Shayshez/Apex4ROBOTS/README.md

# Apex4ROBOTS
1u Peaks for Intellijel format
