Shayshez/Apex4ROBOTS/warning.png

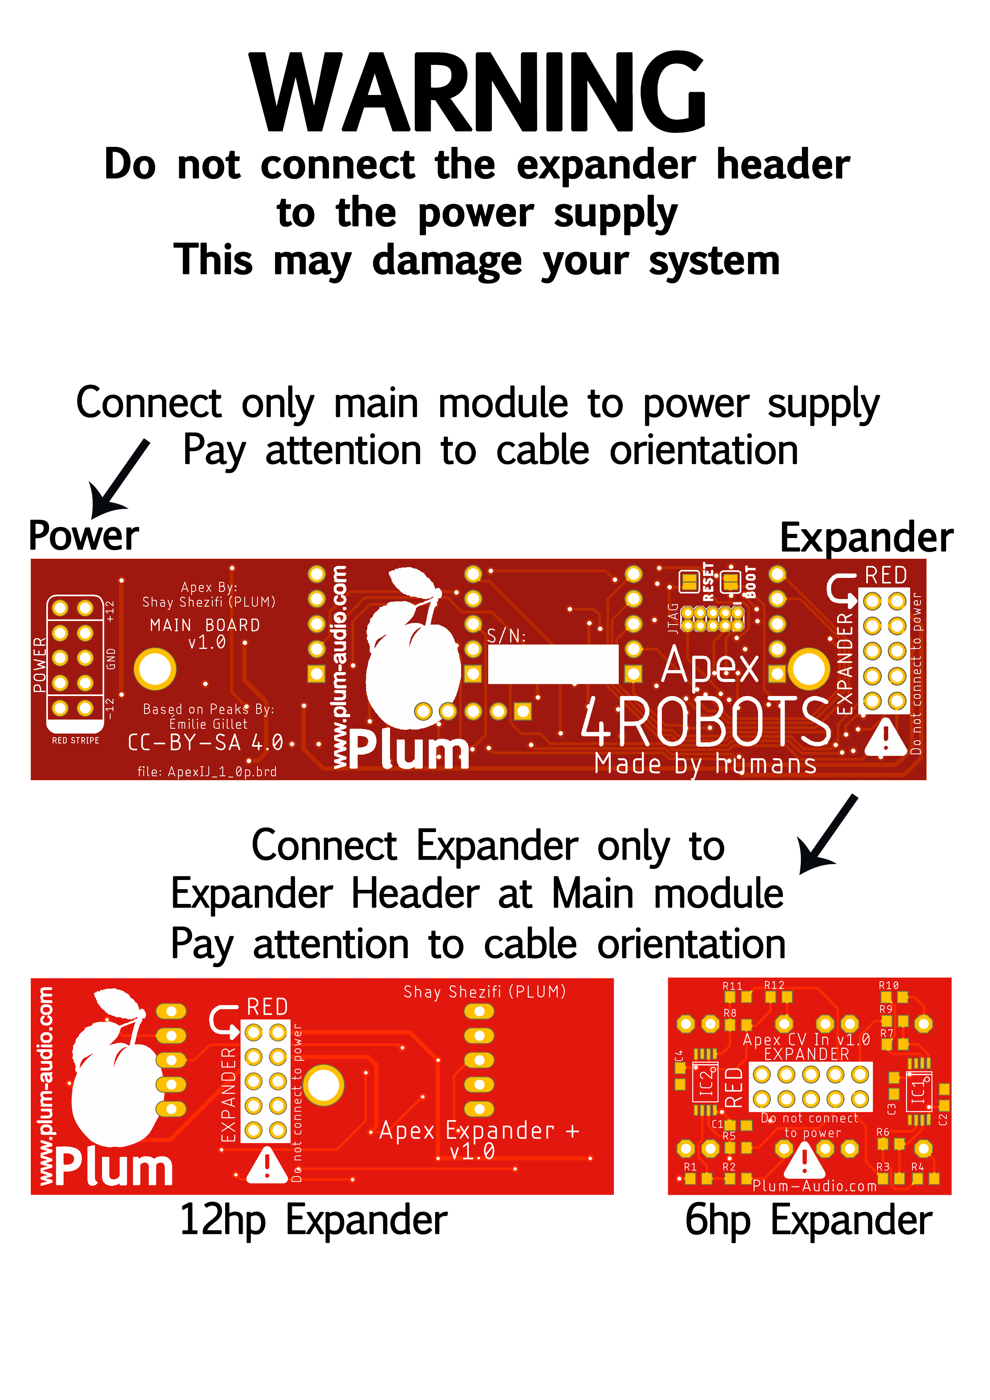
warning.png
