Shayshez/Apex4ROBOTS/Apex4ROBOTS-BOM.xlsx

Sheet: MainBoard
Qty | Value | Device | Package | Parts | Description
1 | 330R | R-US_R0603 | R0603 | R21 | RESISTOR, American symbol
7 | 1.0k | R-US_R0603 | R0603 | R3, R9, R10, R11, R13, R18, R20 | RESISTOR, American symbol
1 | 3.3k | R-US_R0603 | R0603 | R8 | RESISTOR, American symbol
2 | 10k | R-US_R0603 | R0603 | R6, R7 | RESISTOR, American symbol
4 | 33k | R-US_R0603 | R0603 | R1, R2, R4, R5 | RESISTOR, American symbol
6 | 39k | R-US_R0603 | R0603 | R12, R14, R16, R19, R22, R24 | RESISTOR, American symbol
2 | 249k | R-US_R0603 | R0603 | R15, R23 | RESISTOR, American symbol
2 | 309k | R-US_R0603 | R0603 | R17, R25 | RESISTOR, American symbol
4 | 18p | C-USC0603 | C0603 | C4, C5, C21, C25 | CAPACITOR, American symbol
4 | 220p | C-USC0603 | C0603 | C16, C17, C22, C23 | CAPACITOR, American symbol
4 | 560p | C-USC0603 | C0603 | C1, C2, C6, C7 | CAPACITOR, American symbol
11 | 100n | C-USC0603 | C0603 | C3, C8, C9, C10, C11, C13, C14, C19, C20, C24, C27 | CAPACITOR, American symbol
2 | 470n | C-USC0603 | C0603 | C15, C26 | CAPACITOR, American symbol
1 | 3.3u | C-USC0603 | C0603 | C18 | CAPACITOR, American symbol
3 | 22u | CPOL-USC | PANASONIC_C | C12, C28, C29 | POLARIZED CAPACITOR, American symbol
1 | EMI Bead | WE-CBF_0603 | 603 | L1 | SMD EMI Suppression Ferrite Beads
2 | 1N5819HW | DIODE-SOD123 | SOD123 | D1, D2 | DIODE
1 | LM1117-3.3 | REG1117 | SOT223 | IC3 | 800mA and 1A Low Dropout (LDO) Positive Regulator
1 | DAC8552 | DAC8552 | MSOP-8 | IC2
1 | LM4040B10 | LM4041B12DBZ | DBZ_R-PDSO-G3 | IC6 | PRECISION MICROPOWER SHUNT VOLTAGE REFERENCE
1 | LM4040B25 | LM4041B12DBZ | DBZ_R-PDSO-G3 | IC4 | PRECISION MICROPOWER SHUNT VOLTAGE REFERENCE
1 | MCP6004TSSOP14 | MCP6004TSSOP14 | TSSOP14 | IC1
2 | TL072TL072_TSSOP8 | TL072TL072_TSSOP8 | TL072_TSSOP8 | IC5, IC7
1 | STM32F103CBT6 | STM32F103CB | LQFP48 | UC1
1 | 8.0Mhz Crystal | CRYSTAL7A | XTAL500X320X120 | Q1 | CRYSTAL
5 |  | 61300511121 | 61300511121 | J1, J2, J3, J4, J5 | WR-PHD 2.54mm Pin Header, 5 Pin =>Code : Con_BTB_PHD_2.54_1_THT_61300511121
1 |  | 61301021121 | 61301021121 | EXPANDER | WR-PHD 2.54mm Dual Pin Header, 10 Pins =>Code : Con_BTB_PHD_2.54_2_61301021121
1 | M05X2MINIJTAG | M05X2MINIJTAG | 2X5-1.27 | JTAG | Header 5x2
1 | POWER_SIMPLE10 | POWER_SIMPLE10 | POWER_10 | POWER

Sheet: UI Board
Qty | Value | Device | Package | Parts | Description | SPICEPREFIX
2 | 100R | R-US_R0603 | R0603 | R5, R6 | RESISTOR, American symbol
6 | 100k | R-US_R0603 | R0603 | R7, R8, R9, R10, R11, R12 | RESISTOR, American symbol
2 | 10k | R-US_R0603 | R0603 | R19, R25 | RESISTOR, American symbol
4 | 10kB | POTS_POT_USSLOTED_TALL_TRIMMER | POTS_TALL_TRIMMER_POT_VERTICAL_SLOTED | R1, R2, R3, R4
2 | MMBT3904 | MMBT3904LT1-NPN-SOT23-BEC | SOT23-BEC | Q2, Q3 | NPN Transistror
2 | HIGHLY_PB6149L | HIGHLY_PB6149L | HIGHLY_PB64149L | SW_T2, SW_T1
2 | Switch, 6mm | Switch, 6mm | Switch, 6mm | SW1, SW2 | Momentary Switch |  | 612-TL1105SP-250
2 | Cap for switch |  |  | SW1, SW2
5 | LED3MM | LED3MM | LED3MM | LED1, LED2, LED3, LED4, LED5 | LED
4 | OG-PJ301_PJ301_THONKICONN6 | OG-PJ301_PJ301_THONKICONN6 | OG-PJ301_WQP_PJ_301M6 | OUT_A, OUT_B, TRIG_A, TRIG_B
5 | Pin Header Female 2.54 1X5 | Pin Header Female 2.54 1X5 | Pin Header Female 2.54 1X5 | J5, J6, J7, J8, J9 | WR-PHD 2.54mm Pin Header, 5 Pin =>Code : Con_BTB_PHD_2.54_1_THT_61300511121

Sheet: 12HP Ex MainBoard
Qty | Value | Device | Package | Parts | Description | POPULARITY
1 | Pin Headers 2.54 2X5 | 61301021121 | 61301021121 | EXPANDER | WR-PHD 2.54mm Dual Pin Header, 10 Pins =>Code : Con_BTB_PHD_2.54_2_61301021121
2 | Pin Headers 2.54 1X5 | PINHD-1X5 | 1X05 | JP1, JP2 | PIN HEADER | 69
12 | 100.0K | R-US_R0603 | R0603 | R5, R6, R7, R10, R11, R13, R16, R17, R18, R21, R22, R23 | RESISTOR, American symbol
4 | 75K | R-US_R0603 | R0603 | R8, R14, R19, R24 | RESISTOR, American symbol
8 | 100n | C-USC0603 | C0603 | C1, C2, C3, C4, C5, C6, C7, C24 | CAPACITOR, American symbol
4 | TL072TL072_TSSOP8 | TL072TL072_TSSOP8 | TL072_TSSOP8 | IC3, IC4, IC5, IC6

Sheet: 12HP Ex UI Board
Qty | Value | Device | Package | Parts | Description | POPULARITY
2 | Pin Header Female 1X5 | PINHD-1X5 | 1X05 | JP1, JP2 | PIN HEADER | 69
4 | 100.0K | R-US_R0603 | R0603 | R5, R6, R7, R8 | RESISTOR, American symbol
4 | 10kB | POTS_POT_USSLOTED_TALL_TRIMMER | POTS_TALL_TRIMMER_POT_VERTICAL_SLOTED | R1, R2, R3, R4
4 | PJ301_THONKICONN | PJ301_THONKICONN | WQP_PJ_301M6 | J1, J2, J3, J4

Sheet: 6HP CV INS
Qty | Value | Device | Package | Parts | Description
8 | 100K | R-US_R0603 | R0603 | R1, R2, R4, R6, R7, R8, R10, R12 | RESISTOR, American symbol
4 | 75K | R-US_R0603 | R0603 | R3, R5, R9, R11 | RESISTOR, American symbol
4 | 100n | C-USC0603 | C0603 | C1, C2, C3, C4 | CAPACITOR, American symbol
4 | PJ301_THONKICONN | PJ301_THONKICONN | WQP_PJ_301M6 | J1, J2, J3, J4
2 | TL072TL072_TSSOP8 | TL072TL072_TSSOP8 | TL072_TSSOP8 | IC1, IC2
1 | Pin Headers 2.54 2X5 | 61301021121 | 61301021121 | EXPANDER | WR-PHD 2.54mm Dual Pin Header, 10 Pins =>Code : Con_BTB_PHD_2.54_2_61301021121
