Shayshez/Apex4ROBOTS/Expanders/3u:2hp/Apex_CV_Expander_3U_UI_v1.0.brd

## EAGLE design Expanders/3u:2hp/Apex_CV_Expander_3U_UI_v1.0.brd (2020-03-17)

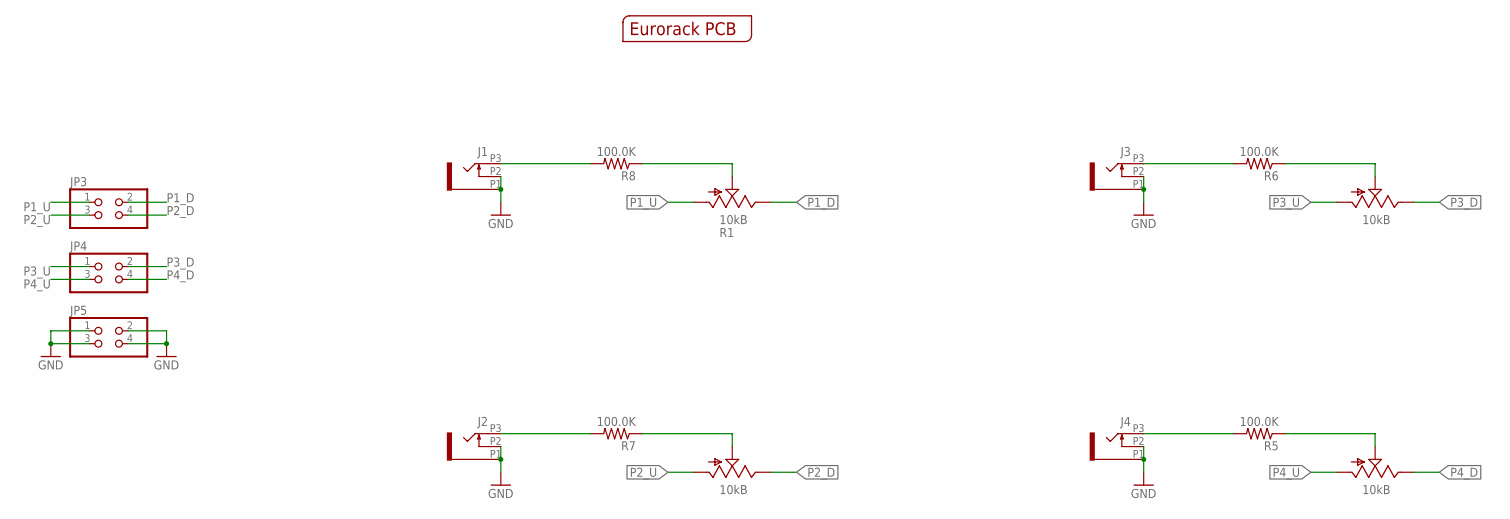
[picture p2: schematic Apex_CV_Expander_3U_UI_v1.0.sch]

Parts:
J1, J2, J3, J4: OG-PJ301_PJ301_THONKICONN7; OG-PJ301_WQP_PJ_301M7
JP3, JP4, JP5: PINHD-2X2; 2X02
PCB1: EURORACK_PCB2HP; EURORACK2HPPCB
R1, R2, R3, R4: 10kB; POTS_TALL_TRIMMER_POT_VERTICAL_SLOTED
R5, R6, R7, R8: 100.0K; R0603

Connections:
GND: J1.P1 (1), J1.P2 (2), J2.P1 (1), J2.P2 (2), J3.P1 (1), J3.P2 (2), J4.P1 (1), J4.P2 (2), JP5.1, JP5.2, JP5.3, JP5.4
unnamed: J1.P3 (3), R8.2
unnamed: R1.P$2 (S), R8.1
unnamed: J2.P3 (3), R7.2
unnamed: R2.P$2 (S), R7.1
unnamed: J3.P3 (3), R6.2
unnamed: R3.P$2 (S), R6.1
unnamed: J4.P3 (3), R5.2
unnamed: R4.P$2 (S), R5.1
P1_D: JP3.2, R1.P$1 (E)
P1_U: JP3.1, R1.P$3 (A)
P2_D: JP3.4, R2.P$1 (E)
P2_U: JP3.3, R2.P$3 (A)
P3_D: JP4.2, R3.P$1 (E)
P3_U: JP4.1, R3.P$3 (A)
P4_D: JP4.4, R4.P$1 (E)
P4_U: JP4.3, R4.P$3 (A)

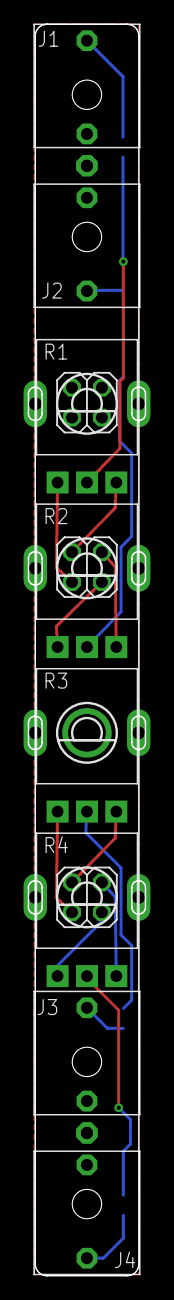
[picture p3: board Apex_CV_Expander_3U_UI_v1.0.brd from above]

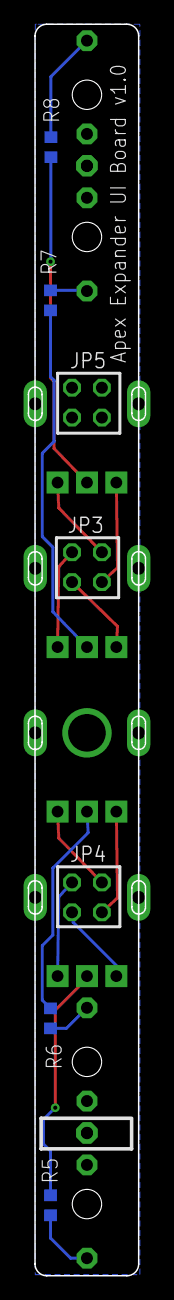
[picture p4: board Apex_CV_Expander_3U_UI_v1.0.brd from below]

Board: 2 copper layers, 10.0 x 106.5 mm, 16 parts (4 on the bottom side), 17 nets.
