Shayshez/Apex4ROBOTS/Expanders/3u:2hp/Apex_CV_Expander_3U_v1.0.brd

## EAGLE design Expanders/3u:2hp/Apex_CV_Expander_3U_v1.0.brd (2020-03-17)

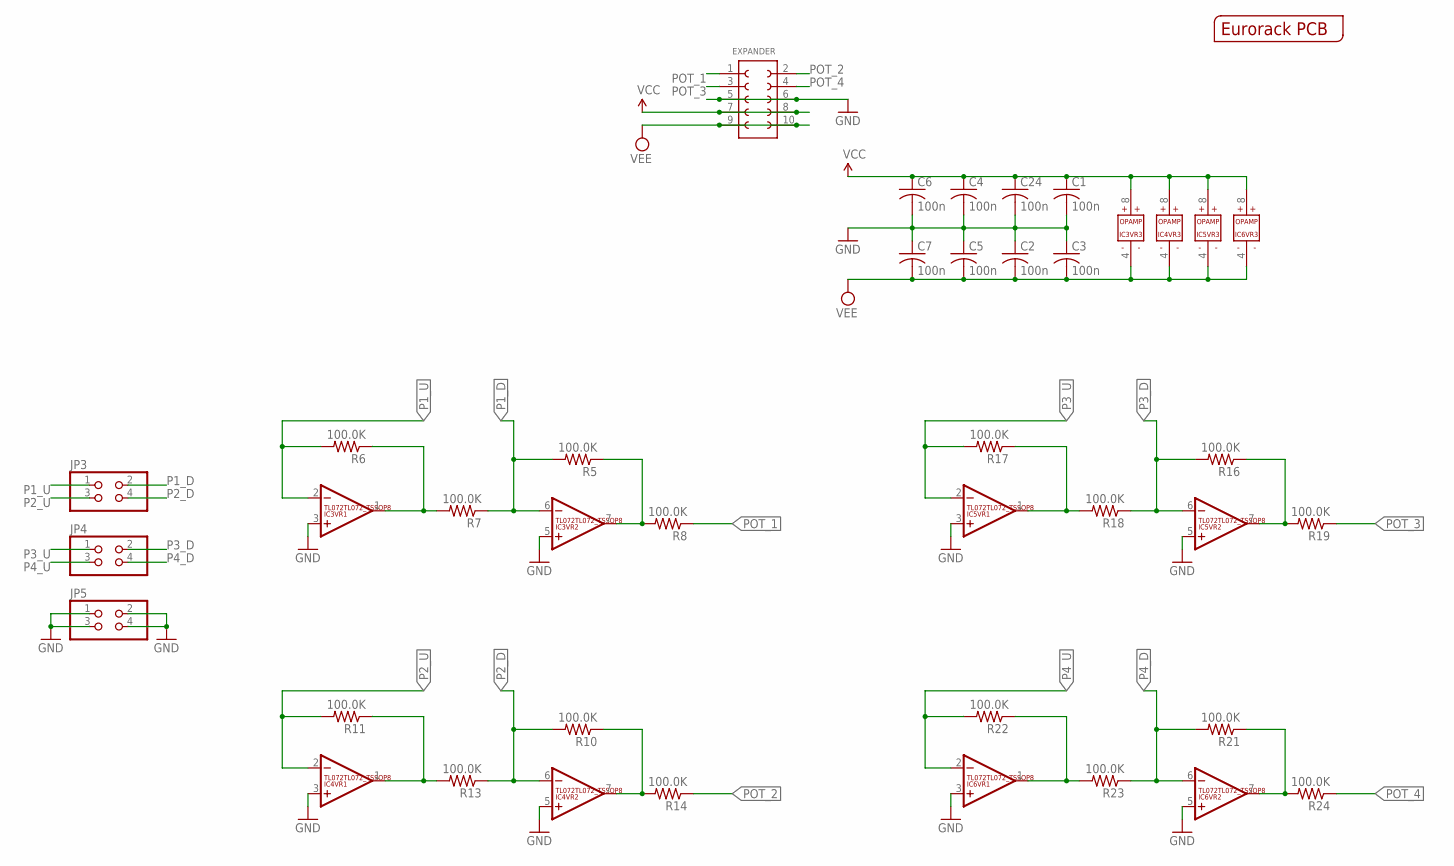
[picture p5: schematic Apex_CV_Expander_3U_v1.0.sch]

Parts:
C1, C2, C3, C4, C5, C6, C7, C24: 100n; C0603
EXPANDER: 61301021121
IC3, IC4, IC5, IC6: TL072TL072_TSSOP8; TL072_TSSOP8
JP3, JP4, JP5: PINHD-2X2; 2X02
PCB1: EURORACK_PCB2HP; EURORACK2HPPCB
R5, R6, R7, R8, R10, R11, R13, R14, R16, R17, R18, R19, R21, R22, R23, R24: 100.0K; R0603

Connections:
GND: C1.2, C2.1, C3.1, C4.2, C5.1, C6.2, C7.1, C24.2, EXPANDER.5 (3), EXPANDER.6 (8), IC3.3 (+IN), IC3.5 (+IN), IC4.3 (+IN), IC4.5 (+IN), IC5.3 (+IN), IC5.5 (+IN), IC6.3 (+IN), IC6.5 (+IN), JP5.1, JP5.2, JP5.3, JP5.4
unnamed: IC3.7 (OUT), R5.1, R8.2
unnamed: IC3.1 (OUT), R6.1, R7.2
unnamed: IC4.7 (OUT), R10.1, R14.2
unnamed: IC4.1 (OUT), R11.1, R13.2
unnamed: IC5.7 (OUT), R16.1, R19.2
unnamed: IC5.1 (OUT), R17.1, R18.2
unnamed: IC6.7 (OUT), R21.1, R24.2
unnamed: IC6.1 (OUT), R22.1, R23.2
P1_D: IC3.6 (-IN), JP3.2, R5.2, R7.1
P1_U: IC3.2 (-IN), JP3.1, R6.2
P2_D: IC4.6 (-IN), JP3.4, R10.2, R13.1
P2_U: IC4.2 (-IN), JP3.3, R11.2
P3_D: IC5.6 (-IN), JP4.2, R16.2, R18.1
P3_U: IC5.2 (-IN), JP4.1, R17.2
P4_D: IC6.6 (-IN), JP4.4, R21.2, R23.1
P4_U: IC6.2 (-IN), JP4.3, R22.2
POT_1: EXPANDER.1, R8.1
POT_2: EXPANDER.2 (10), R14.1
POT_3: EXPANDER.3 (2), R19.1
POT_4: EXPANDER.4 (9), R24.1
VCC: C1.1, C4.1, C6.1, C24.1, EXPANDER.7 (4), EXPANDER.8 (7), IC3.8 (V+), IC4.8 (V+), IC5.8 (V+), IC6.8 (V+)
VEE: C2.2, C3.2, C5.2, C7.2, EXPANDER.9 (5), EXPANDER.10 (6), IC3.4 (V-), IC4.4 (V-), IC5.4 (V-), IC6.4 (V-)

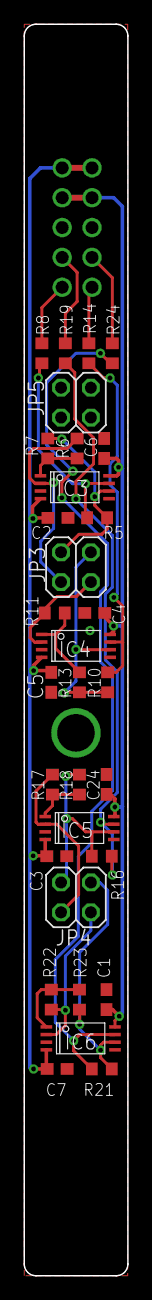
[picture p6: board Apex_CV_Expander_3U_v1.0.brd from above]

Board: 2 copper layers, 8.8 x 106.5 mm, 33 parts (1 on the bottom side), 23 nets.
