Shayshez/Apex4ROBOTS/Apex4ROBOTS_1_0.brd

## EAGLE design Apex4ROBOTS_1_0.brd (2019-12-17)

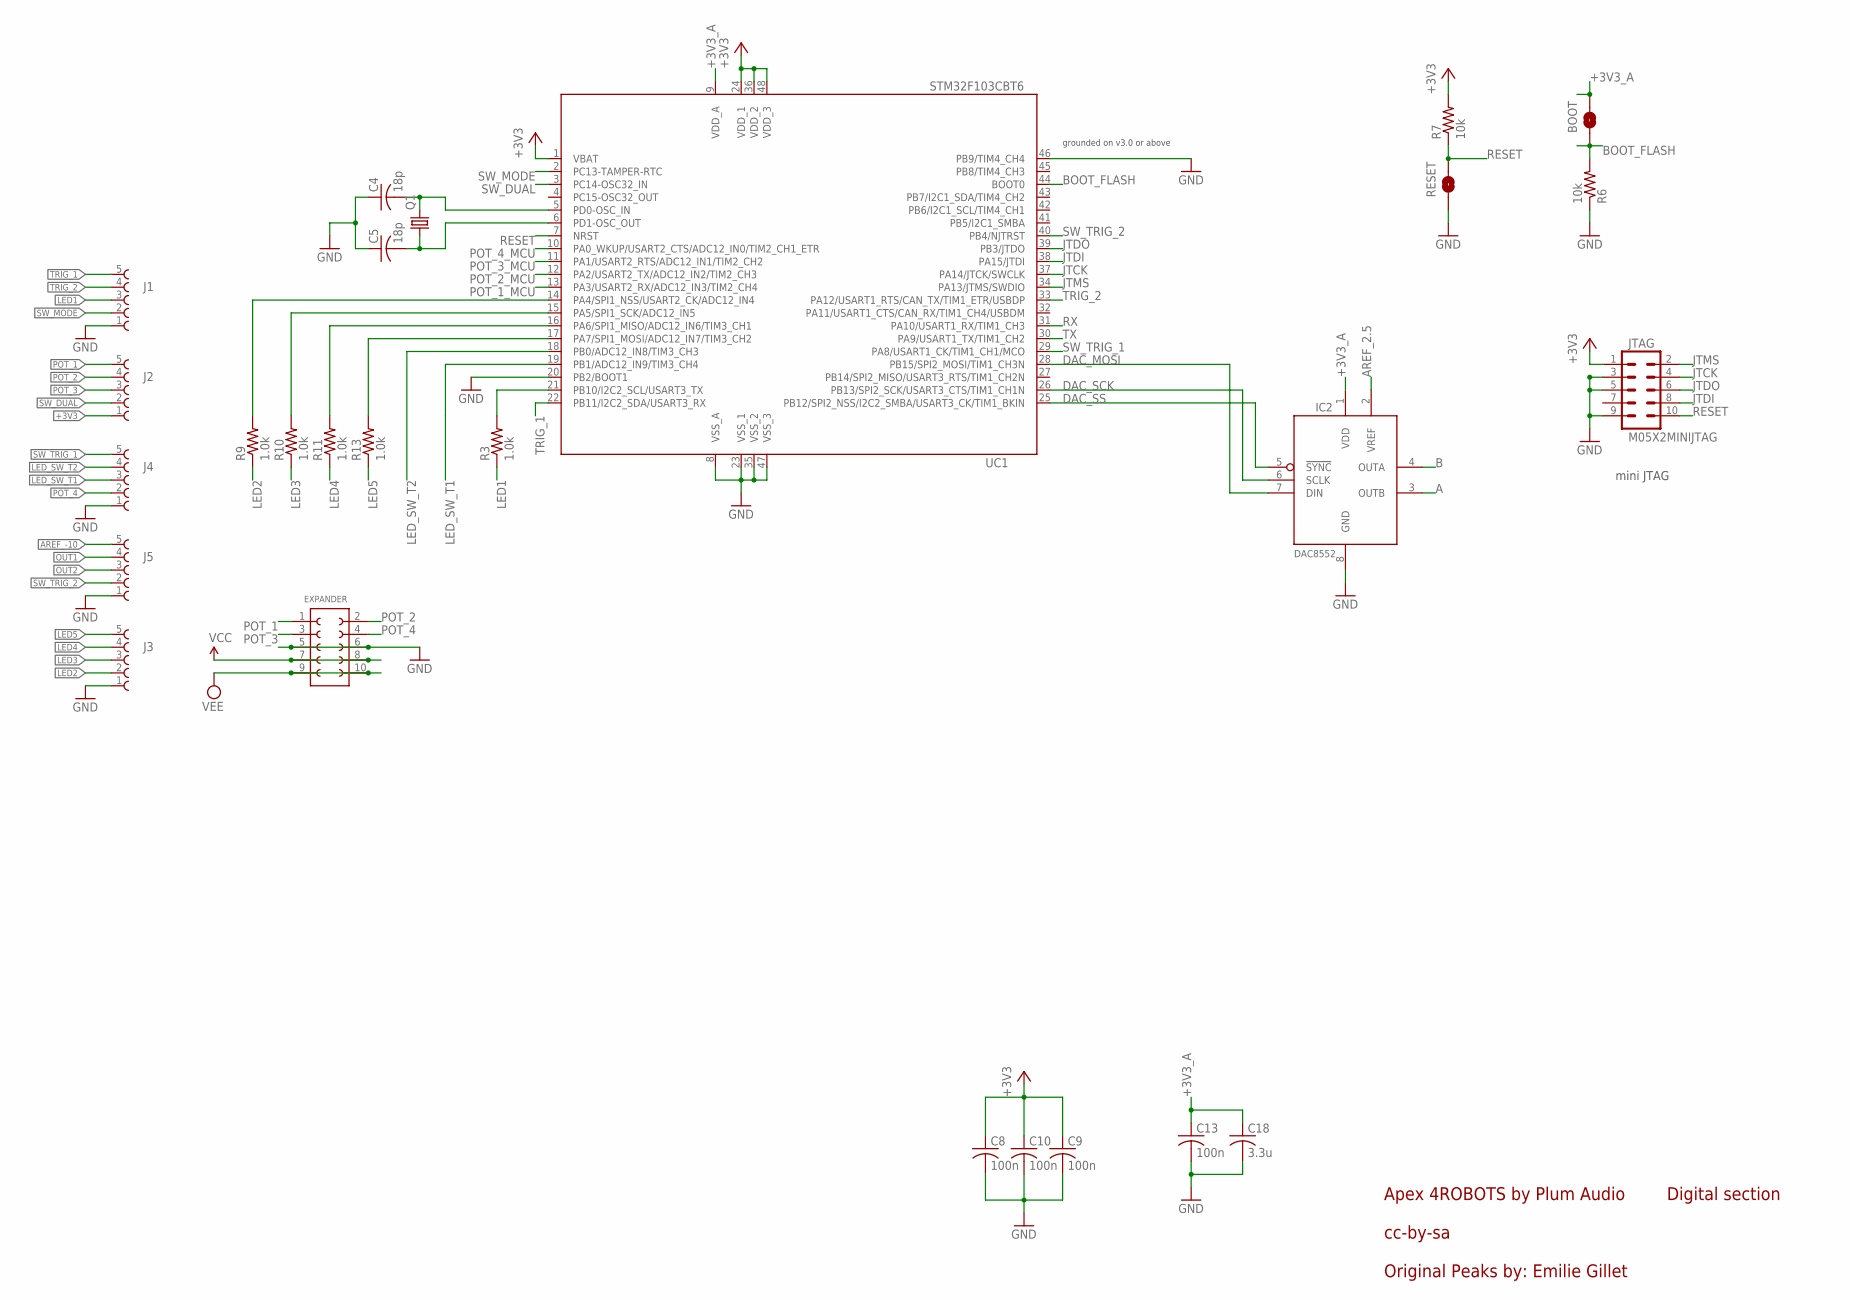
[picture p7: schematic Apex4ROBOTS_1_0.sch, sheet 1]

Parts:
BOOT: BOOT; SMT-JUMPER_2_NO_SILK
C4, C5: 18p; C0603
C8, C9, C10, C13: 100n; C0603
C18: 3.3u; C0603
EXPANDER: 61301021121
IC2: DAC8552; MSOP-8
J1, J2, J3, J4, J5: 61300511121
JTAG: M05X2MINIJTAG; 2X5-1.27
Q1: CRYSTAL7A; XTAL500X320X120
R3, R9, R10, R11, R13: 1.0k; R0603
R6, R7: 10k; R0603
RESET: RESET; SMT-JUMPER_2_NO_SILK
UC1: STM32F103CBT6; LQFP48

Connections:
+3V3: C8.1, C9.1, C10.1, J2.1 (5), JTAG.1, R7.2, UC1.1 (VBAT), UC1.24 (VDD_1), UC1.36 (VDD_2), UC1.48 (VDD_3); also elsewhere on the board
+3V3_A: BOOT.2, C13.1, C18.1, IC2.1 (VDD), UC1.9 (VDD_A); also elsewhere on the board
A: IC2.3 (OUTB); also elsewhere on the board
AREF_2.5: IC2.2 (VREF); also elsewhere on the board
AREF_-10: J5.5 (1); also elsewhere on the board
B: IC2.4 (OUTA); also elsewhere on the board
BOOT_FLASH: BOOT.1, R6.2, UC1.44 (BOOT0)
DAC_MOSI: IC2.7 (DIN), UC1.28 (PB15/SPI2_MOSI/TIM1_CH3N)
DAC_SCK: IC2.6 (SCLK), UC1.26 (PB13/SPI2_SCK/USART3_CTS/TIM1_CH1N)
DAC_SS: IC2.5 (!SYNC), UC1.25 (PB12/SPI2_NSS/I2C2_SMBA/USART3_CK/TIM1_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)
GND: C4.1, C5.1, C8.2, C9.2, C10.2, C13.2, C18.2, EXPANDER.5 (3), EXPANDER.6 (8), IC2.8 (GND), J1.1 (5), J3.1 (5), J4.1 (5), J5.1 (5), JTAG.3, JTAG.5, JTAG.9, R6.1, RESET.1, UC1.8 (VSS_A), UC1.20 (PB2/BOOT1), UC1.23 (VSS_1), UC1.35 (VSS_2), UC1.46 (PB9/TIM4_CH4), UC1.47 (VSS_3); also elsewhere on the board
JTCK: JTAG.4, UC1.37 (PA14/JTCK/SWCLK)
JTDI: JTAG.8, UC1.38 (PA15/JTDI)
JTDO: JTAG.6, UC1.39 (PB3/JTDO)
JTMS: JTAG.2, UC1.34 (PA13/JTMS/SWDIO)
LED1: J1.3, R3.1
LED2: J3.2 (4), R9.1
LED3: J3.3, R10.1
LED4: J3.4 (2), R11.1
LED5: J3.5 (1), R13.1
LED_SW_T1: J4.3, UC1.19 (PB1/ADC12_IN9/TIM3_CH4)
LED_SW_T2: J4.4 (2), UC1.18 (PB0/ADC12_IN8/TIM3_CH3)
unnamed: C4.2, Q1.2, UC1.5 (PD0-OSC_IN)
unnamed: C5.2, Q1.1, UC1.6 (PD1-OSC_OUT)
unnamed: R9.2, UC1.14 (PA4/SPI1_NSS/USART2_CK/ADC12_IN4)
unnamed: R10.2, UC1.15 (PA5/SPI1_SCK/ADC12_IN5)
unnamed: R11.2, UC1.16 (PA6/SPI1_MISO/ADC12_IN6/TIM3_CH1)
unnamed: R13.2, UC1.17 (PA7/SPI1_MOSI/ADC12_IN7/TIM3_CH2)
unnamed: R3.2, UC1.21 (PB10/I2C2_SCL/USART3_TX)
OUT1: J5.4 (2); also elsewhere on the board
OUT2: J5.3; also elsewhere on the board
POT_1: EXPANDER.1, J2.5 (1); also elsewhere on the board
POT_1_MCU: UC1.13 (PA3/USART2_RX/ADC12_IN3/TIM2_CH4); also elsewhere on the board
POT_2: EXPANDER.2 (10), J2.4 (2); also elsewhere on the board
POT_2_MCU: UC1.12 (PA2/USART2_TX/ADC12_IN2/TIM2_CH3); also elsewhere on the board
POT_3: EXPANDER.3 (2), J2.3; also elsewhere on the board
POT_3_MCU: UC1.11 (PA1/USART2_RTS/ADC12_IN1/TIM2_CH2); also elsewhere on the board
POT_4: EXPANDER.4 (9), J4.2 (4); also elsewhere on the board
POT_4_MCU: UC1.10 (PA0_WKUP/USART2_CTS/ADC12_IN0/TIM2_CH1_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); also elsewhere on the board
RESET: JTAG.10, R7.1, RESET.2, UC1.7 (NRST)
RX: UC1.31 (PA10/USART1_RX/TIM1_CH3)
SW_DUAL: J2.2 (4), UC1.3 (PC14-OSC32_IN)
SW_MODE: J1.2 (4), UC1.2 (PC13-TAMPER-RTC)
SW_TRIG_1: J4.5 (1), UC1.29 (PA8/USART1_CK/TIM1_CH1/MCO)
SW_TRIG_2: J5.2 (4), UC1.40 (PB4/NJTRST)
TRIG_1: J1.5 (1), UC1.22 (PB11/I2C2_SDA/USART3_RX)
TRIG_2: J1.4 (2), UC1.33 (PA12/USART1_RTS/CAN_TX/TIM1_ETR/USBDP)
TX: UC1.30 (PA9/USART1_TX/TIM1_CH2)
VCC: EXPANDER.7 (4), EXPANDER.8 (7); also elsewhere on the board
VEE: EXPANDER.9 (5), EXPANDER.10 (6); also elsewhere on the board

Notes on the sheet:
cc-by-sa
Original Peaks by: Emilie Gillet
Digital section
mini JTAG
grounded on v3.0 or above
Apex 4ROBOTS by Plum Audio

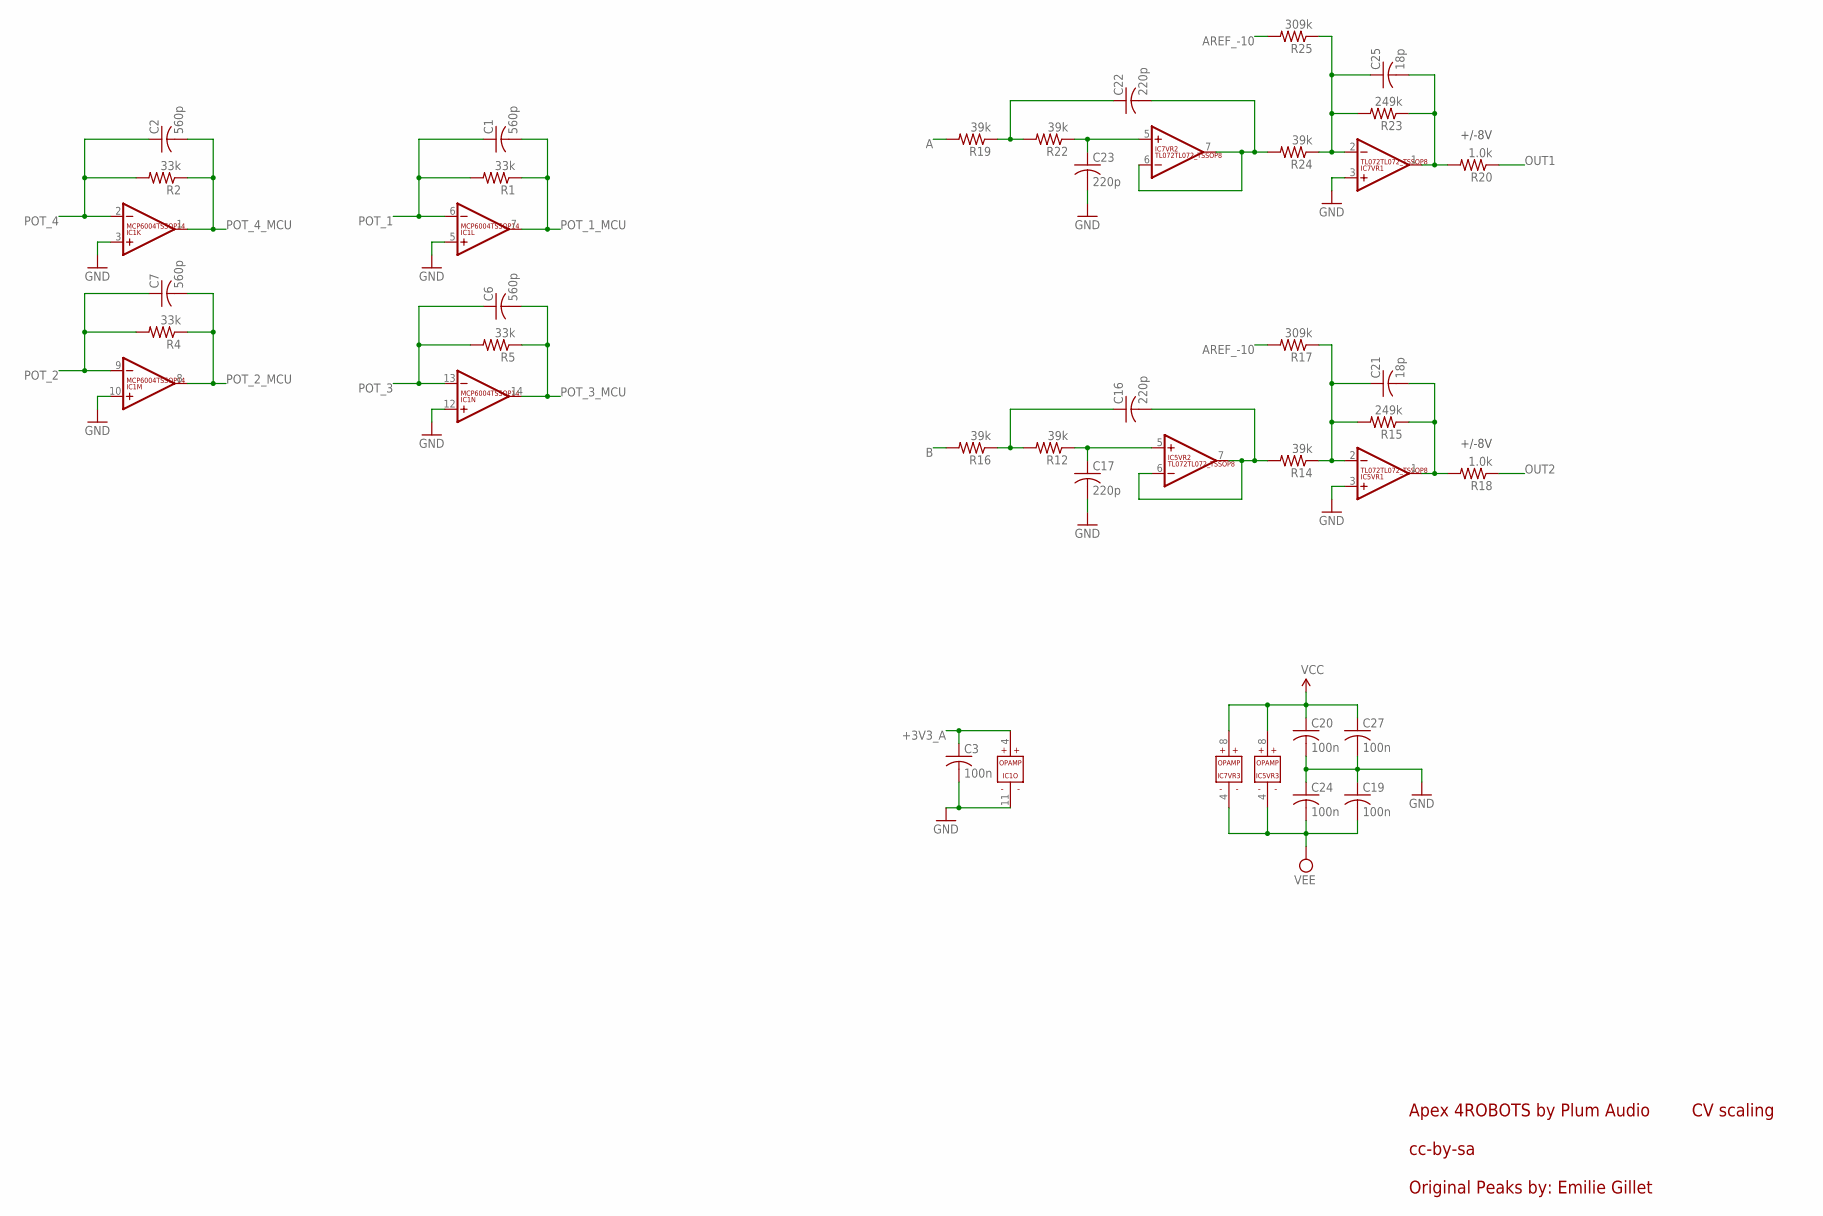
[picture p8: schematic Apex4ROBOTS_1_0.sch, sheet 2]

Parts:
C1, C2, C6, C7: 560p; C0603
C3, C19, C20, C24, C27: 100n; C0603
C16, C17, C22, C23: 220p; C0603
C21, C25: 18p; C0603
IC1: MCP6004TSSOP14; TSSOP14
IC5, IC7: TL072TL072_TSSOP8; TL072_TSSOP8
R1, R2, R4, R5: 33k; R0603
R12, R14, R16, R19, R22, R24: 39k; R0603
R15, R23: 249k; R0603
R17, R25: 309k; R0603
R18, R20: 1.0k; R0603

Connections:
+3V3_A: C3.1, IC1.4 (V+); also elsewhere on the board
A: R19.2; also elsewhere on the board
AREF_-10: R17.2, R25.2; also elsewhere on the board
B: R16.2; also elsewhere on the board
BI_OUT: C21.2, IC5.1 (OUT), R15.1, R18.2
BI_OUT1: C25.2, IC7.1 (OUT), R20.2, R23.1
F_CV: C21.1, IC5.2 (-IN), R14.1, R15.2, R17.1
F_CV1: C25.1, IC7.2 (-IN), R23.2, R24.1, R25.1
GND: C3.2, C17.2, C19.1, C20.2, C23.2, C24.1, C27.2, IC1.3 (+IN), IC1.5 (+IN), IC1.10 (+IN), IC1.11 (V-), IC1.12 (+IN), IC5.3 (+IN), IC7.3 (+IN); also elsewhere on the board
unnamed: C22.2, IC7.6 (-IN), IC7.7 (OUT), R24.2
unnamed: C23.1, IC7.5 (+IN), R22.1
unnamed: C22.1, R19.1, R22.2
unnamed: C16.2, IC5.6 (-IN), IC5.7 (OUT), R14.2
unnamed: C17.1, IC5.5 (+IN), R12.1
unnamed: C16.1, R12.2, R16.1
OUT1: R20.1; also elsewhere on the board
OUT2: R18.1; also elsewhere on the board
POT_1: C1.1, IC1.6 (-IN), R1.2; also elsewhere on the board
POT_1_MCU: C1.2, IC1.7 (OUT), R1.1; also elsewhere on the board
POT_2: C7.1, IC1.9 (-IN), R4.2; also elsewhere on the board
POT_2_MCU: C7.2, IC1.8 (OUT), R4.1; also elsewhere on the board
POT_3: C6.1, IC1.13 (-IN), R5.2; also elsewhere on the board
POT_3_MCU: C6.2, IC1.14 (OUT), R5.1; also elsewhere on the board
POT_4: C2.1, IC1.2 (-IN), R2.2; also elsewhere on the board
POT_4_MCU: C2.2, IC1.1 (OUT), R2.1; also elsewhere on the board
VCC: C20.1, C27.1, IC5.8 (V+), IC7.8 (V+); also elsewhere on the board
VEE: C19.2, C24.2, IC5.4 (V-), IC7.4 (V-); also elsewhere on the board

Notes on the sheet:
+/-8V
CV scaling
cc-by-sa
Original Peaks by: Emilie Gillet
Apex 4ROBOTS by Plum Audio

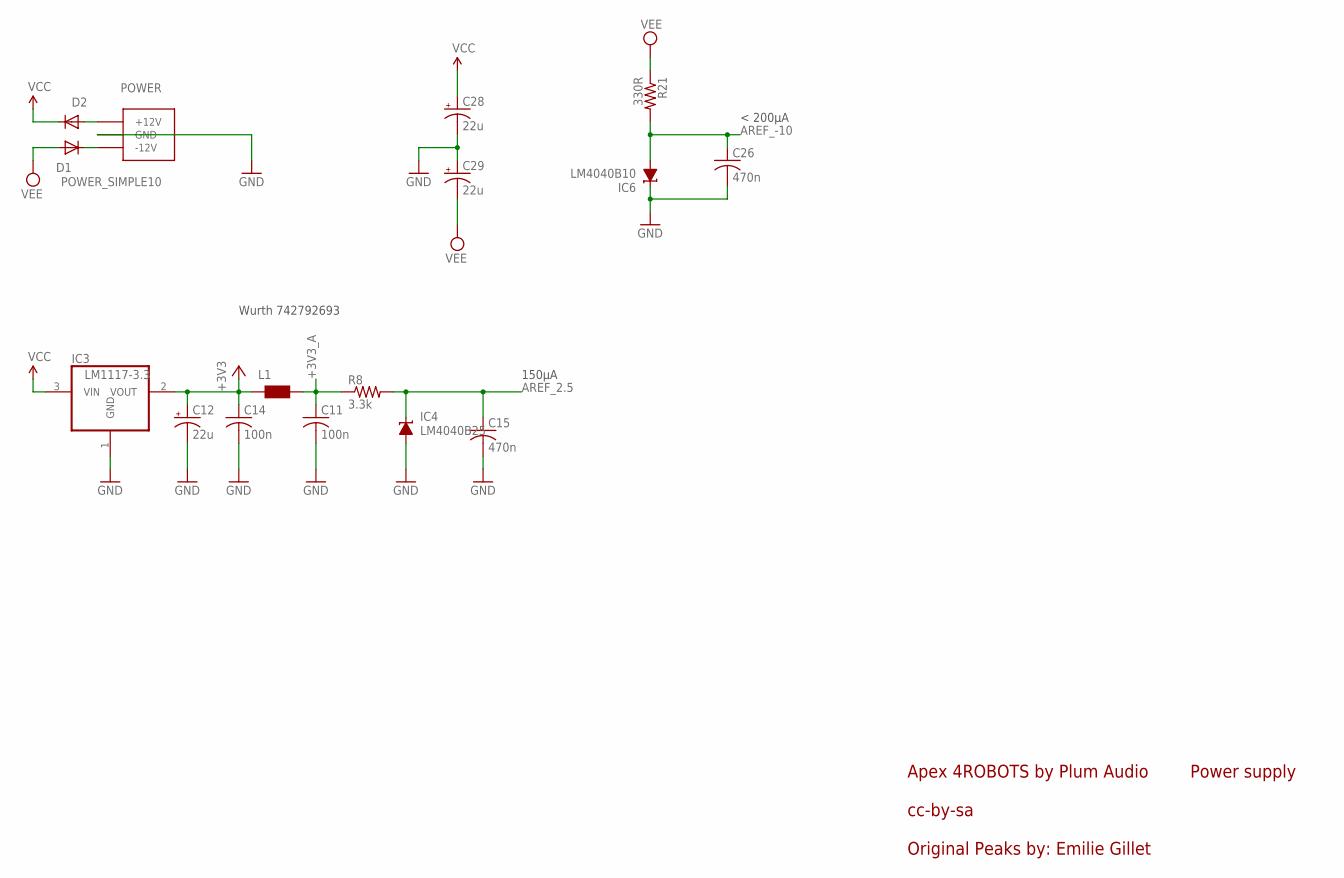
[picture p9: schematic Apex4ROBOTS_1_0.sch, sheet 3]

Parts:
C11, C14: 100n; C0603
C12, C28, C29: 22u; PANASONIC_C
C15, C26: 470n; C0603
D1, D2: 1N5819HW; SOD123
IC3: LM1117-3.3; SOT223
IC4: LM4040B25; DBZ_R-PDSO-G3
IC6: LM4040B10; DBZ_R-PDSO-G3
L1: WE-CBF_0603; 0603
POWER: POWER_SIMPLE10; POWER_10
R8: 3.3k; R0603
R21: 330R; R0603

Connections:
+3V3: C12.+, C14.1, IC3.2 (VOUT), L1.1; also elsewhere on the board
+3V3_A: C11.1, L1.2, R8.1; also elsewhere on the board
AREF_2.5: C15.1, IC4.1 (C), R8.2; also elsewhere on the board
AREF_-10: C26.1, IC6.2 (A), R21.2; also elsewhere on the board
GND: C11.2, C12.-, C14.2, C15.2, C26.2, C28.-, C29.+, IC3.1 (GND), IC4.2 (A), IC6.1 (C), POWER.3 (GND), POWER.4 (GND), POWER.5 (GND), POWER.6 (GND), POWER.7 (GND), POWER.8 (GND); also elsewhere on the board
unnamed: D2.A, POWER.9 (+12V), POWER.10 (+12V)
unnamed: D1.C, POWER.1 (-12V), POWER.2 (-12V)
VCC: C28.+, D2.C, IC3.3 (VIN); also elsewhere on the board
VEE: C29.-, D1.A, R21.1; also elsewhere on the board

Notes on the sheet:
Power supply
Wurth 742792693
< 200µA
150µA
cc-by-sa
Original Peaks by: Emilie Gillet
Apex 4ROBOTS by Plum Audio

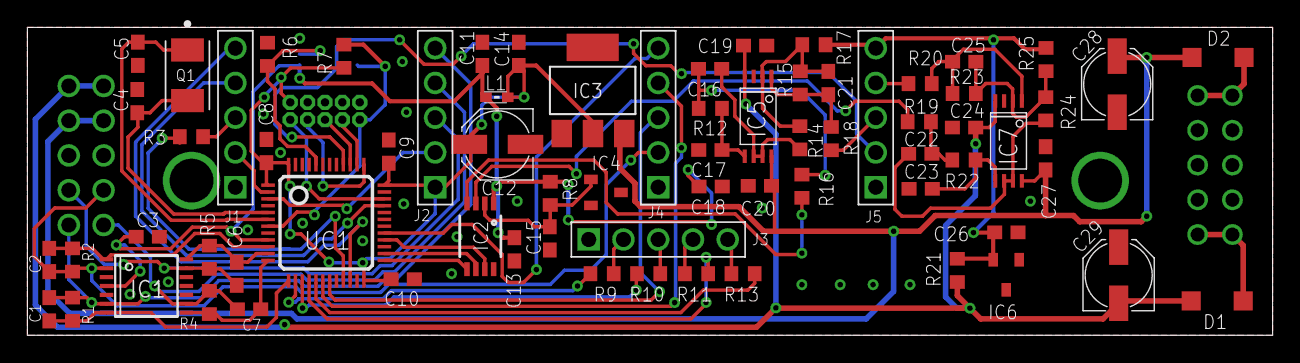
[picture p10: board Apex4ROBOTS_1_0.brd from above]

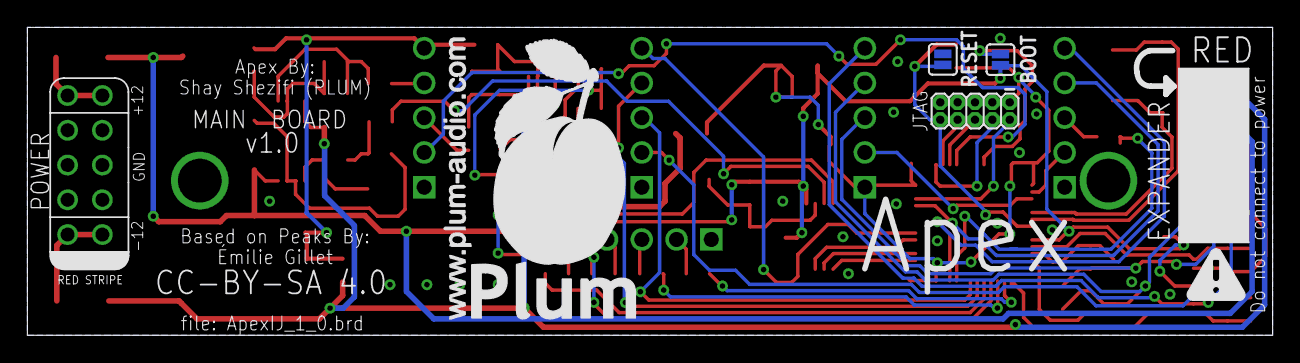
[picture p11: board Apex4ROBOTS_1_0.brd from below]

Board: 2 copper layers, 91.0 x 22.5 mm, 76 parts (5 on the bottom side), 60 nets.
