Shayshez/Apex4ROBOTS/Apex4ROBOTS_UI_1_0.brd

## EAGLE design Apex4ROBOTS_UI_1_0.brd (2019-12-17)

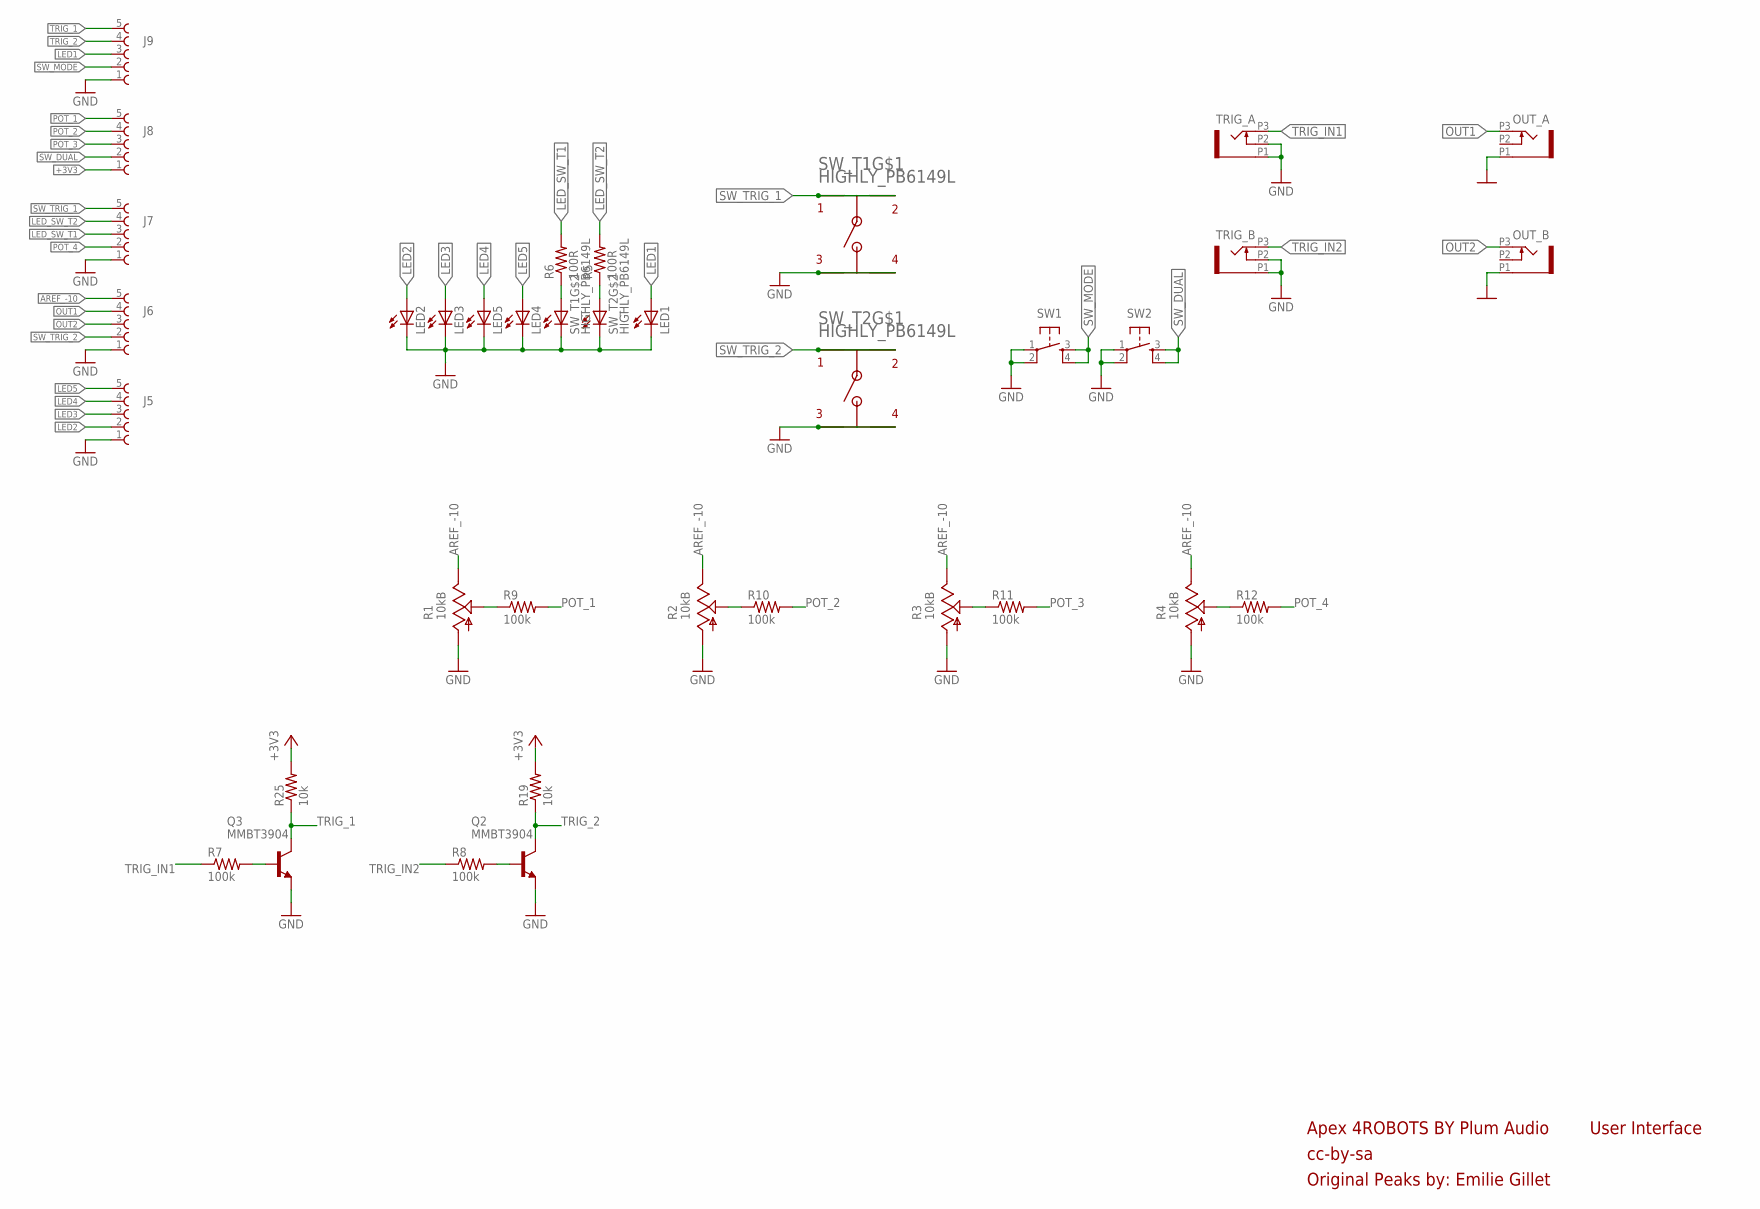
[picture p12: schematic Apex4ROBOTS_UI_1_0.sch]

Parts:
J5, J6, J7, J8, J9: 61300511121
LED1, LED2, LED3, LED4, LED5: LED3MM
OUT_A: OG-PJ301_PJ301_THONKICONN6; OG-PJ301_WQP_PJ_301M6
OUT_B: OG-PJ301_PJ301_THONKICONN6; OG-PJ301_WQP_PJ_301M6
Q2, Q3: MMBT3904; SOT23-BEC
R1, R2, R3, R4: 10kB; POTS_TALL_TRIMMER_POT_VERTICAL_SLOTED
R5, R6: 100R; R0603
R7, R8, R9, R10, R11, R12: 100k; R0603
R19, R25: 10k; R0603
SW1, SW2: TAC_SWITCHPTH; TACTILE-PTH
SW_T1, SW_T2: HIGHLY_PB6149L; HIGHLY_PB64149L
TRIG_A: OG-PJ301_PJ301_THONKICONN6; OG-PJ301_WQP_PJ_301M6
TRIG_B: OG-PJ301_PJ301_THONKICONN6; OG-PJ301_WQP_PJ_301M6

Connections:
+3V3: J8.1 (5), R19.2, R25.2
AREF_-10: J6.5 (1), R1.P$1 (E), R2.P$1 (E), R3.P$1 (E), R4.P$1 (E)
GND: J5.1 (5), J6.1 (5), J7.1 (5), J9.1 (5), LED1.K (C), LED2.K (C), LED3.K (C), LED4.K (C), LED5.K (C), OUT_A.P1 (1), OUT_B.P1 (1), Q2.E, Q3.E, R1.P$3 (A), R2.P$3 (A), R3.P$3 (A), R4.P$3 (A), SW1.1, SW1.2, SW2.1, SW2.2, SW_T1.L2, SW_T1.P$3, SW_T1.P$4, SW_T2.L2, SW_T2.P$3, SW_T2.P$4, TRIG_A.P1 (1), TRIG_A.P2 (2), TRIG_B.P1 (1), TRIG_B.P2 (2)
LED1: J9.3, LED1.A
LED2: J5.2 (4), LED2.A
LED3: J5.3, LED3.A
LED4: J5.4 (2), LED5.A
LED5: J5.5 (1), LED4.A
LED_SW_T1: J7.3, R6.2
LED_SW_T2: J7.4 (2), R5.2
unnamed: R5.1, SW_T2.L1
unnamed: R6.1, SW_T1.L1
unnamed: R1.P$2 (S), R9.1
unnamed: R2.P$2 (S), R10.1
unnamed: R3.P$2 (S), R11.1
unnamed: R4.P$2 (S), R12.1
unnamed: Q2.B, R8.2
unnamed: Q3.B, R7.2
OUT1: J6.4 (2), OUT_A.P3 (3)
OUT2: J6.3, OUT_B.P3 (3)
POT_1: J8.5 (1), R9.2
POT_2: J8.4 (2), R10.2
POT_3: J8.3, R11.2
POT_4: J7.2 (4), R12.2
SW_DUAL: J8.2 (4), SW2.3, SW2.4
SW_MODE: J9.2 (4), SW1.3, SW1.4
SW_TRIG_1: J7.5 (1), SW_T1.P$1, SW_T1.P$2
SW_TRIG_2: J6.2 (4), SW_T2.P$1, SW_T2.P$2
TRIG_1: J9.5 (1), Q3.C, R25.1
TRIG_2: J9.4 (2), Q2.C, R19.1
TRIG_IN1: R7.1, TRIG_A.P3 (3)
TRIG_IN2: R8.1, TRIG_B.P3 (3)

Notes on the sheet:
cc-by-sa
Original Peaks by: Emilie Gillet
User Interface
Apex 4ROBOTS BY Plum Audio

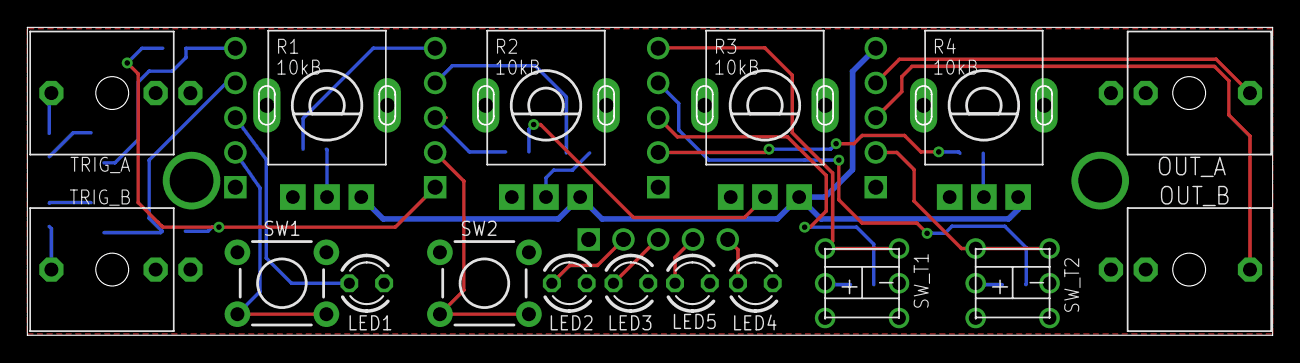
[picture p13: board Apex4ROBOTS_UI_1_0.brd from above]

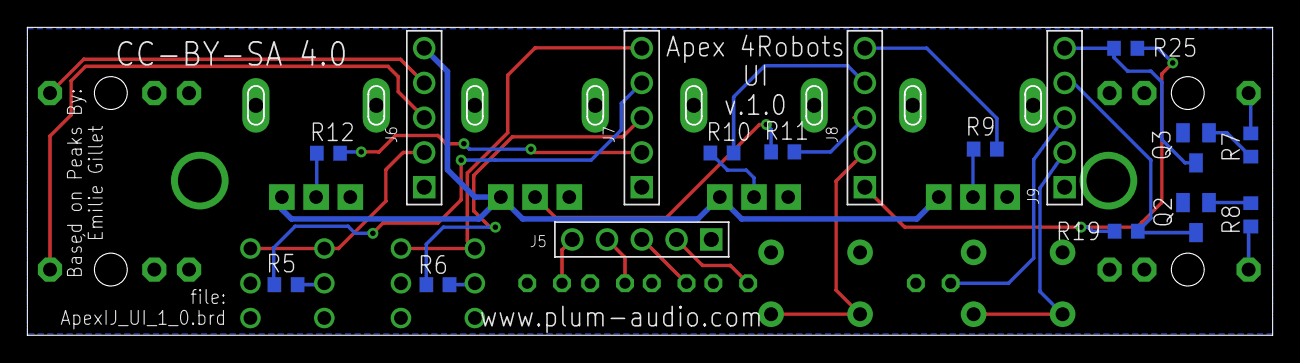
[picture p14: board Apex4ROBOTS_UI_1_0.brd from below]

Board: 2 copper layers, 91.0 x 22.5 mm, 34 parts (17 on the bottom side), 32 nets.
