Shayshez/Apex4ROBOTS/(notices)

Notices in the files:
Apex4ROBOTS_UI_1_0.brd:
CC-BY-SA 4.0
parts and their libraries:
Wurth_Elektronik_Electromechanic_Board_t: Copyright: Würth Elektronik
SparkFun-Jumpers: Licensing: Creative Commons ShareAlike 4.0 International - https://creativecommons.org/licenses/by-sa/4.0
